ABC-iRobotics/go2-fancontrol/doc/schematic.pdf

12V | 5V

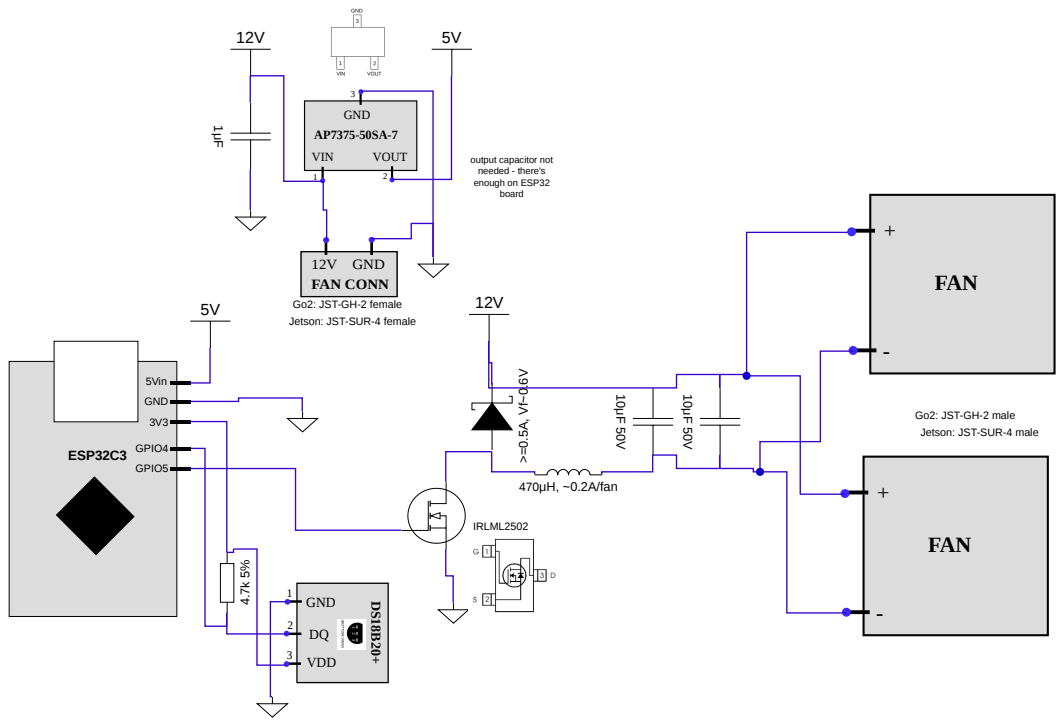
[picture p1: page 1]
IRLML2502; 5Vin; GND; GPIO4; GPIO5; ESP32C3; 470μH, ~0.2A/fan¹⁰μF 50V >=0.5A, Vf~0.6V

output capacitor not
needed - there's
enough on ESP32
board

Go2: JST-GH-2 female
Jetson: JST-SUR-4 female

Go2: JST-GH-2 male
Jetson: JST-SUR-4 male
