ABC-iRobotics/go2-fancontrol/(commit log)

2026-09-04 Add initial BLE code and hw schematic.
2026-09-17 Fix USB CDC mode, BLE tested, works.
    [ble_client.py, esp32fw.ino]
2026-09-25 First deployed version.
    Thermal management with PI control loop,
    some basic config commands
    BLE advertised fan speed and temp
2026-10-14 Set TX_POWER, MAC, new fan.
    Set higher TX_POWER on BLE.
    Set explicit BLE address to distinguish modules.
    Update docs.
    Add new aliexpress fan conf.
